mklasinc/lumarca-workshop/README.md

# Lumarca Workshop
This repo contains files related to the Lumarca community building workshop at NYU Abu Dhabi in Fall 2017. <br> [Lumarca](http://lumarca.info/) is a projection mapping project that uses strings distributed in space to project content onto a 3-D display.
