mklasinc/lumarca-workshop/Construction/instructable_printed_instructions.pdf

http://www.instructables.com/id/How-to-Build-a-Wiremap/

All | Art (http://www.instructables.com/art?utm_source=pdf&utm_campaign=categories) | Craft (http://www.instructables.com/craft?utm_source=pdf&utm_campaign=categories) | Food (http://www.instructables.com/food?utm_source=pdf&utm_campaign=categories) | Games (http://www.instructables.com/games?utm_source=pdf&utm_campaign=categories) | Green (http://www.instructables.com/green?utm_source=pdf&utm_campaign=categories) | Home (http://www.instructables.com/home?utm_source=pdf&utm_campaign=categories) | Kids (http://www.instructables.com/kids?utm_source=pdf&utm_campaign=categories) | Life (http://www.instructables.com/life?utm_source=pdf&utm_campaign=categories) | Music (http://www.instructables.com/music?utm_source=pdf&utm_campaign=categories) | Offbeat (http://www.instructables.com/offbeat?utm_source=pdf&utm_campaign=categories) | Outdoors (http://www.instructables.com/outdoors?utm_source=pdf&utm_campaign=categories) | Pets (http://www.instructables.com/pets?utm_source=pdf&utm_campaign=categories) | Photo (http://www.instructables.com/photography?utm_source=pdf&utm_campaign=categories) | Ride (http://www.instructables.com/ride?utm_source=pdf&utm_campaign=categories) | Science (http://www.instructables.com/science?utm_source=pdf&utm_campaign=categories) | Tech (http://www.instructables.com/tech?utm_source=pdf&utm_campaign=categories)

# How to Build a Wiremap

by phedhex (http://www.instructables.com/member/phedhex/?utm_source=pdf&utm_campaign=title) on February 1, 2009

Table of Contents

Author:phedhex author's website (http://www.phedhex.com/) twitter: phedhex

Mailing list:
http://www.phedhex.com/mailing_list/

## Intro: How to Build a Wiremap

The Wiremap is a project that builds digital 3d objects in real 3d space. To create digital 3d objects in real 3d space, a projector is placed in front of a custom designed projection surface made up of an array of vertical wires.

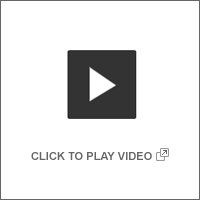
[picture p1: figure]

If you'd like to learn more about the project in general, you can do so at the Wiremap website (http://wiremap.phedhex.com) .

This instructable will show you how to build your own Wiremap from scratch.

Before we begin - let's just make sure that your computer system will run the programs that I've built. For windows users, download the following: http://wiremap.phedhex.com/instructable/wiremap_instructable_windows.zip

For mac & linux, download the following:
http://wiremap.phedhex.com/instructable/wiremap_instructable_nonwin.zip
Then, go to http://www.processing.org and download the program. Processing will allow you to run the programs in the zip.

Windows - open calib_64 -> application.windows -> calib_64.exe. If you see a bunch of multicolored lines going across your whole screen, you're good.

Other OS - open calib_64.pde with processing. If you see a bunch of multicolored lines going across your whole screen, you're good.

Press escape to exit the program.

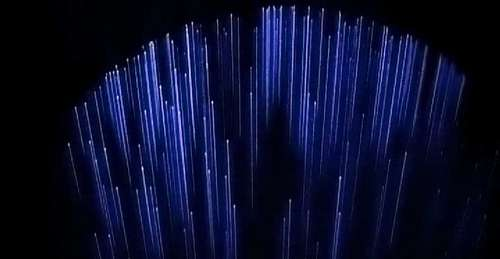
[picture p2: figure]

## Step 1: Understanding the Main Concept

Before we dive in, let's take a look at the anatomy of a Wiremap. The diagram below is a bird's eye view of a projector throwing it's light.

In regular situations, the projector hits a surface at a given distance. Pretend there is a screen at the line labeled "mapline" that the projector is hitting. Now, take that screen and cut it up into a bunch of vertical strips. By moving some strips closer towards the projector, the projector effectively projects in 3d space.

The projector is fed by a computer that has the depths of all the vertical strips memorized. Through this, we can build digital 3d objects in real space.

The Process

Learn about your projector.
Figure out how many wires you want in your wiremap.
Trace out the layout of your projection on some foam core. Mark where you want your wires to go on that foam core. Drop thread through those spots
Calibrate
And run your program

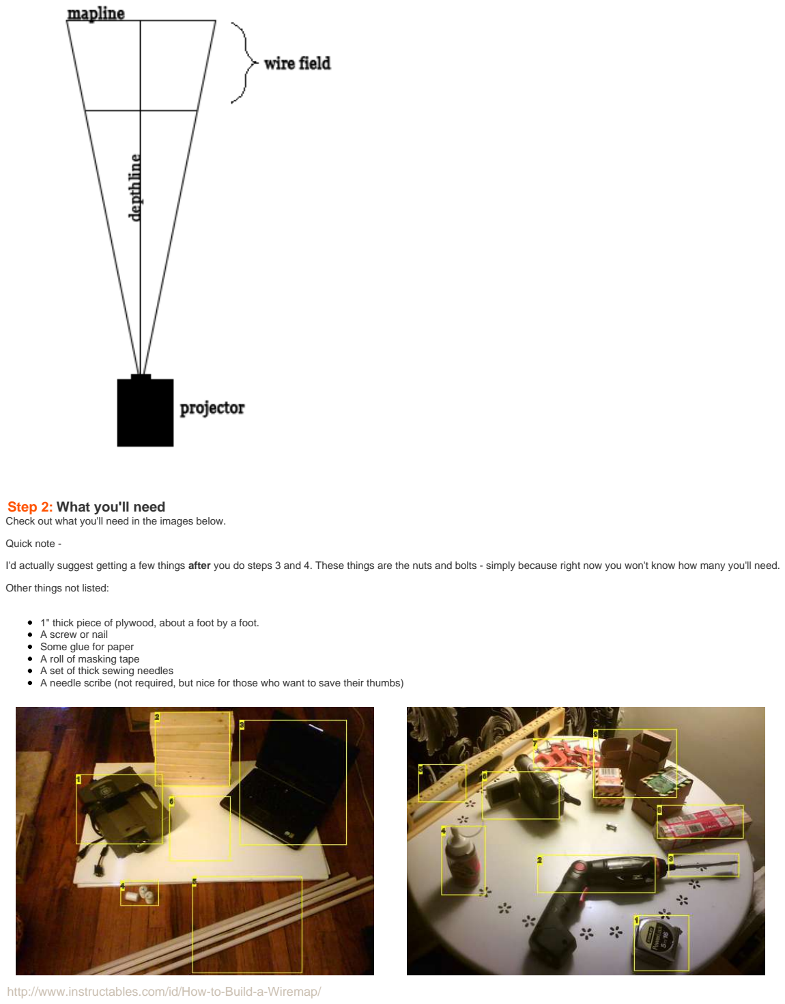
[picture p3: page 3]

## Step 2: What you'll need

Check out what you'll need in the images below.

Quick note -

I'd actually suggest getting a few things after you do steps 3 and 4. These things are the nuts and bolts - simply because right now you won't know how many you'll need.

Other things not listed:

1" thick piece of plywood, about a foot by a foot.
A screw or nail
Some glue for paper
A roll of masking tape
A set of thick sewing needles
A needle scribe (not required, but nice for those who want to save their thumbs)

Image Notes
1. Projector - you probably want a manual zoom (like a twist on the lens) if you have a choice.
2. 2"x4", 8 pieces a foot in length
3. Some sorta computer to feed an image to your projector
4. White thread - you'll want something kinda strong. Get two spools (I used a little over one spool of 125 yards).
5. 4 wood dowels, 3/4 inch in diameter and 4 feet long
6. White Foam core - 3 sheets of 3/8th inch 36"x24".

Image Notes
1. Measuring tape
2. Drill
3. Drill bit - same diameter as your dowels - 3/4 inch
4. Wood glue
5. Level
6. Either a digital camera or camcorder - something with a decent sized screen.
7. 8 C clamps. Wide enough to clamp around your 3/4" dowels
8. Shims
9. Nuts and bolts (check out next image for details)

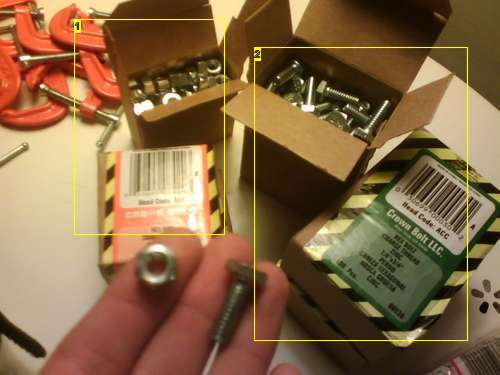
[picture p4: figure]

Image Notes
1. Hex nuts - I got 1/4 inch hex nuts.
2. Bolts that match the threading of the hex nuts. The smaller the length the better

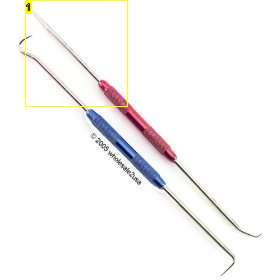
[picture p5: figure]

Image Notes
1. You only need the thin pointy one. Available at craft and hardware stores for about 5 bucks.

## Step 3: Getting to know your projector

In order to design your layout, you'll need to know a few things about your projector. Download and Print out this XL sheet and record your results there: http://wiremap.phedhex.com/instructable/worksheet.xls

Native Aspect Ratio:
Image 1: (width / height)

Throw ratio of the tightest zoom:
Image 1: (width / depth)

Throw ratio of the widest zoom:
Image 2: (width / depth)

Closest focus:
Image 3: Distance from projector to image.

Native resolution:
(not pictured): check your projector's documentation.

As an example, for my particular project, I have these stats:

throw @ tightest zoom: 27" : 72"
throw @ widest zoom: 36" : 72", or 1:2
native aspect: 4:3
Closest focus: 45"
Native res: 1024 x 768

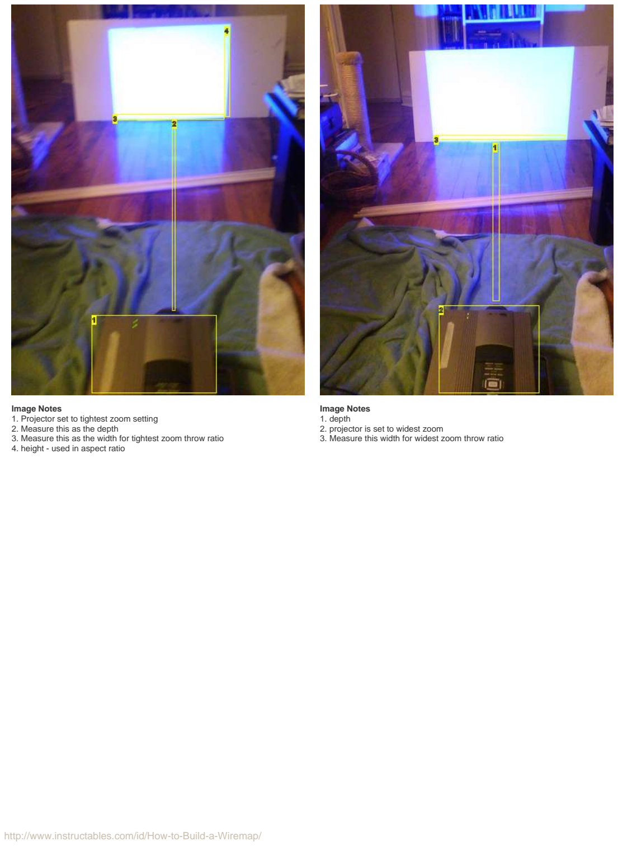
[picture p6: page 5]

Image Notes
1. Projector set to tightest zoom setting
2. Measure this as the depth
3. Measure this as the width for tightest zoom throw ratio
4. height - used in aspect ratio

Image Notes
1. depth
2. projector is set to widest zoom
3. Measure this width for widest zoom throw ratio

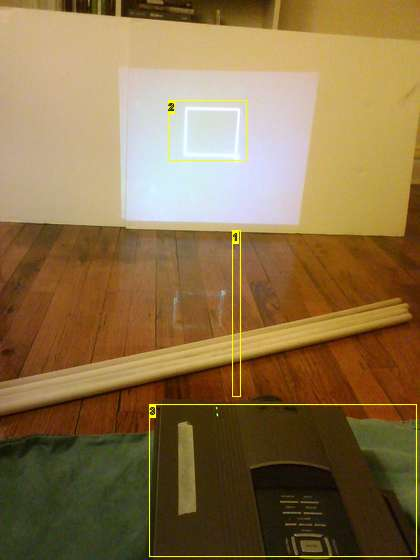
[picture p7: figure]

Image Notes
1. Distance from projector to image for closest focus
2. Make sure the image rendered is as clear as possible
3. Make sure the projector lens is set to the closest focus

## Step 4: How Many Wires?

The number of wires you choose to have in your wiremap will effect you in two ways. With less wires, you'll have an easier time constructing and calibrating your project. With more wires, you'll have to be more precise during construction and calibration, but the end result will have a higher resolution.

If you're looking to learn about the project, 64 wires should be fine. You'll get a good idea as to how things work, and you'll still get a pretty cool effect with a few of the programs. If you're looking for something more challenging, try 96 or so wires. And if you're into intricate work and are willing to spend a bit of time on this project, try 128.

In any case, once you figure out what you want, write down the following on your xl sheet:

64 wires
Available to projectors w/ a horizontal res of 1024, 1152, 1280, or 1920
Mapline Length: 32"
Map Unit: 1/2"
Depth Unit: 1/2"
Depth Levels: 40

80 wires
Available to projectors w/ a horizontal res of 800, 1280, or 1920 Mapline Length: 35"
Map Unit: 7 / 16"
Depth Unit: 7 / 16"
Depth Levels: 45

96 wires
Available to projectors w/ a horizontal res of 1152, or 1920 Mapline Length: 30"
Map Unit: 5 / 16"
Depth Unit: 5 / 16"
Depth Levels: 64

100 wires
Available only if your projector's horizontal res is 800 Mapline Length: 31.25"
Map Unit: 5 / 16"
Depth Unit: 5 / 16"
Depth Levels: 64

128 wires

Available to projectors w/ a horizontal res of 1024, 1152, 1280, or 1920 Mapline Length: 32"
Map Unit: 1/4"
Depth Unit: 1/4"
Depth Levels: 80

How many nuts and bolts do you need? Just take your number of wires and double it!

In case you were wondering what these values are: The mapline length is the width of your projection at a given distance. Remember how I explained this in the beginning with the vertical strips? The number of wires is the number of vertical strips, and the map unit is the distance between each vertical strip.

Determining the Depth

Here are the two guidelines for figuring out how close your wire field is to your projector.

1 - Throw Ratios Notice in the image below: you've got a depthline and a mapline. The length of these lines are the same measurements you used to determine your minimum and maximum throw ratios. The ratio for your plan must fall within your projector's throw ratio.

2 - Closest zoom The center of your wire field must be further than your closest zoom measurement.

So, given that your mapline is a fixed width, find a depth that works for both your throw ratio and your focal distance.

Example please!

So, for my construction, I went with 128. My mapline length is 32".

My widest ratio is 1:2. With a fixed mapline of 32", the depth for this throw ratio would be:

depth = x
1:2 = 32": x corresponding ratios
1 * x = 32" * 2 cross mutiply
x = 64"

My tightest ratio is 27:72.

depth = z
27 : 72 = 32" : z corresponding ratios 27 * z = 32" * 72 cross multiply
z = (72 * 32") / 27 divide
z = 85.333

To fit my projector's throw ratio, my depth must be between 64" and 85"

Closest zoom

My projector's closest zoom distance is 45". The center of the wire field must be greater than 45" away from my projector. Because the wire field is 20" deep (as is everybody's), the center of the wire field is 10" shorter than the depth. So, as long as my map line is greater than 55" out (45" + 10"), then I'll be okay.

For my case, I can just disregard this because my throw ratios are more limiting than that anyhow.

I ended up settling on a 68" depth from my projector to the mapline. This gives me a 4 inch margin of error (I'd always give myself at least a 2" margin of error, just for good measure).

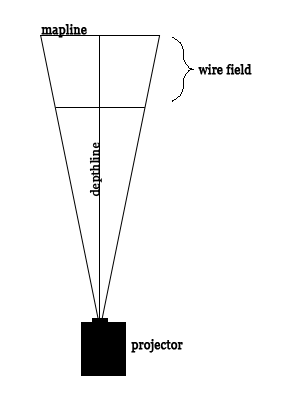
[picture p8: figure]

## Step 5: Determining the Depth

The first step to plotting out your wiremap is to figure out your project's depth. Your Wiremap's depth is the distance from the projector to your mapline. Here are the two guidelines for figuring this out.

1 - Throw Ratios: In the image below there are two angles of projection - the wide zoom and the tight zoom. Because the your mapline length is fixed, the length of the projection is determined by your projector's throw ratios.

2 - Closest Focus: The center of your wire field must be further than your closest focus measurement. Or, in other words, your depthline must be longer than closest focus + 10"

Then, if you have any choice in the matter - a smaller depth tends to make calibration easier.

Example please!

So, for my construction, I went with 128. My mapline length is 32".

My widest ratio is 1:2. With a fixed mapline of 32", the depth for this throw ratio would be:

depth = x
1:2 = 32": x corresponding ratios
1 * x = 32" * 2 cross mutiply
x = 64"

My tightest ratio is 27:72.

depth = z
27 : 72 = 32" : z corresponding ratios 27 * z = 32" * 72 cross multiply
z = (72 * 32") / 27 divide
z = 85.333

To fit my projector's throw ratio, my depth must be between 64" and 85"

Closest zoom

My projector's closest focus distance is 45". The center of the wire field must be greater than 45" away from my projector. Because the wire field is 20" deep (as is everybody's), the center of the wire field is 10" shorter than the depth. So, as long as my map line is greater than 55" out (45" + 10"), then I'll be okay.

For my case, I can just disregard this because my throw ratios are more limiting than that anyhow.

I ended up settling on a 68" depth from my projector to the mapline. This gives me a 4 inch margin of error (I'd always give myself at least a 2" margin of error, just for good measure).

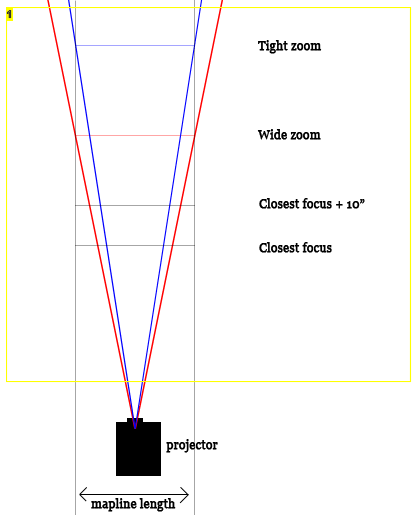
[picture p9: figure]

Image Notes
1. This is an example of where mine land. Yours may land in different places.

## Step 6: Plotting Your Faceplate: Layout

(image 1)
The first step is to draw a line down the center of your foam core. This is your depth line. Next, draw a line along a long edge, 2 inches away from the edge (use another piece of foam core as a straight edge). This is your mapline.

(image 2)
Where the mapline and the depth line is is the center of your mapline. Draw tick marks around the center of your mapline, coming out in either direction. Each tick mark is a "map unit" length away from the next. Half the tick marks on one side of the depth line, half on the other. Note - the depthline is half way between two mapline ticks.

Once you get your tick marks down, the distance between your left-most tick mark and your right-most tick mark should be equal to your mapline length minus one map unit length.

(image 3)
Starting from your left-most tick mark and your right-most tick mark, draw two lines parallel to the depth line. These are your depth level guides.

Along both depth level guide, draw tick marks. Each tick mark is a "depth unit" length away from the next, with the mapline being 0. Draw as many ticks as you have depth levels.

(image 4)
Once you have both depth level guides ticked out, connect them. That is, draw a series of lines parallel to your mapline. Once again, use another piece of foam core as a straight edge.

(image 5)
The last step in plotting your layout is marking everything:

Mark the mapline tick marks from 0 to wires - 1 (for me, I numbered from 0 to 127). 0 is on the left side looking towards the projector.

Mark the depth levels from 0 to however many depth levels you have. The mapline is depth level 0, and the next parallel line is level 1, and so on...

Great! Now you're ready to plot some points.

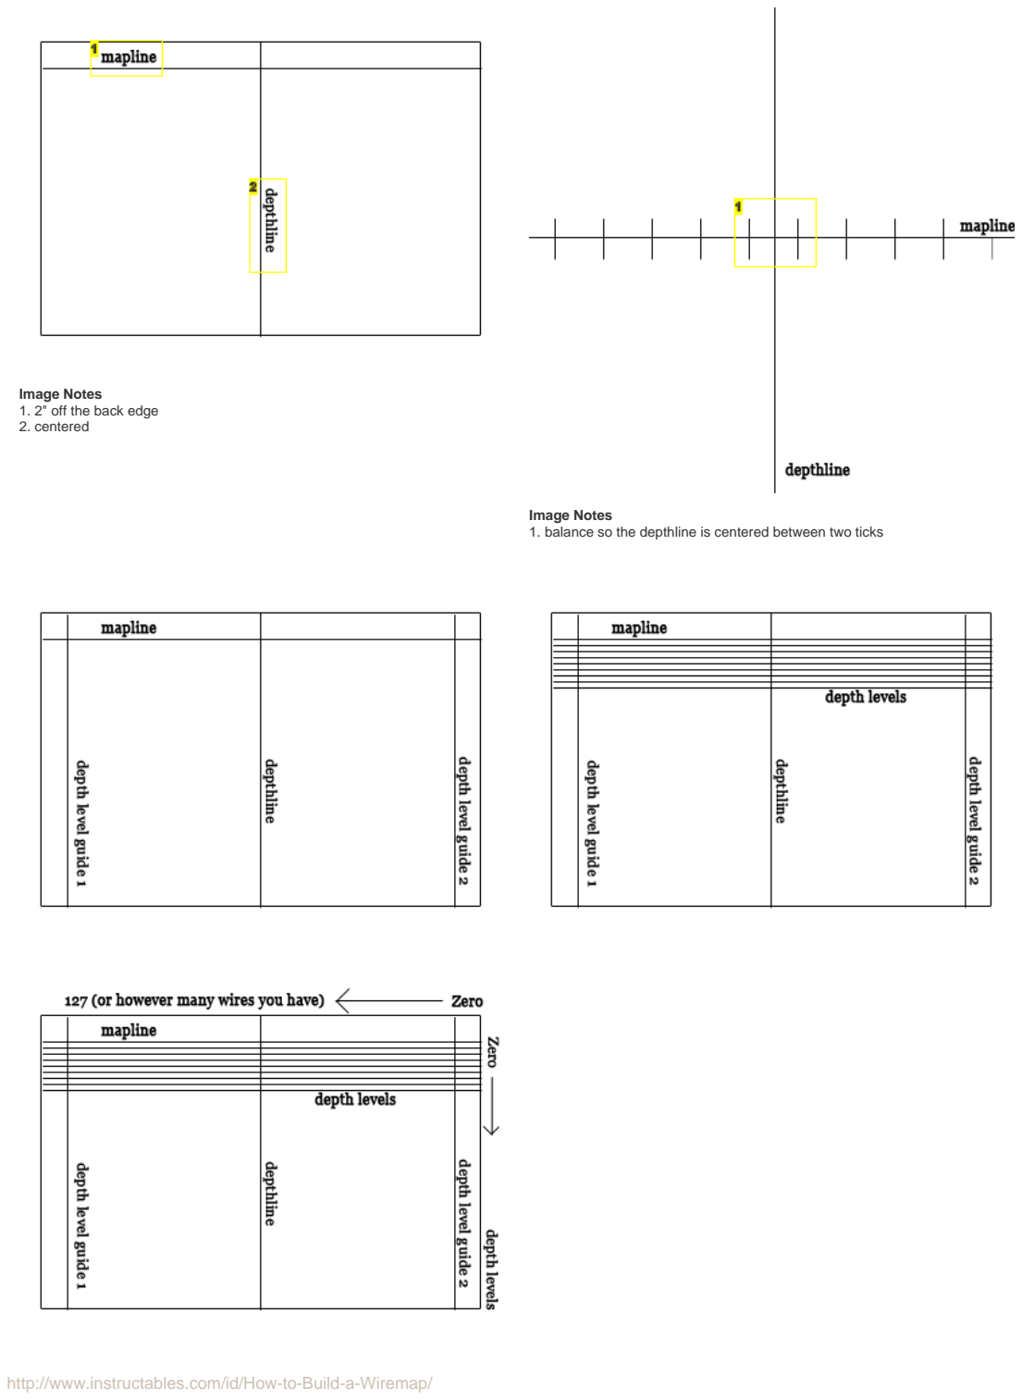
[picture p10: page 10]

Image Notes
1. 2" off the back edge
2. centered

Image Notes
1. balance so the depthline is centered between two ticks

## Step 7: Ray Tracing

In this step, we'll make a straight edge between the projector's focal point and the mapline.

Glue two pieces of foam core together. When gluing them together, try to stay within an inch or two the outside edges (so that when you pierce holes into your foam core, you won't have to struggle through the glue).. Then tape this to the third piece of foam core. Then - tape it all to the floor:

core | ===============
| taped to
core | ===============
| glued to
core | ===============
| taped to
floor _._._._._._._._._._._._._._._._._

Now, measure out where your projector should roughly go (centered on the depth line and as far from the mapline as your depth is). Tape a piece of plywood at that spot.

Draw the depth line onto your plywood. A good way to get the straight edge here is to tape a piece of string to the center of the mapline and pull it taught. When it matches the depthline on the foam core, mark up your plywood and draw it out.

Then, measure from your mapline to draw the intersect - where your projector sits.

Take some thread and tie it off on a hex nut. Drill a screw (or nail a hammer) through the hex nut into the intersection on the plywood.

Now you have a straight edge long enough to follow your path of light!

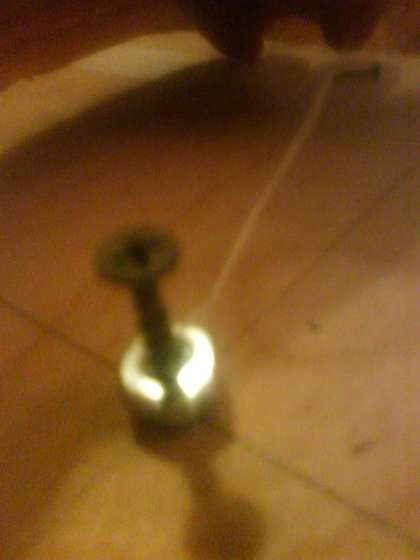
[picture p11: figure]
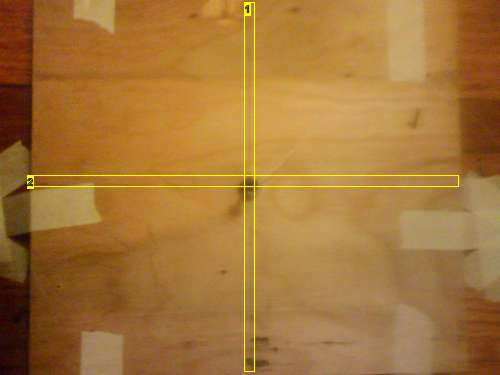
[picture p12: figure]

Image Notes
1. depth line - an extension of the line that goes down the center of the foam core
2. This line is parallel to your mapline, and back as far as your depth.

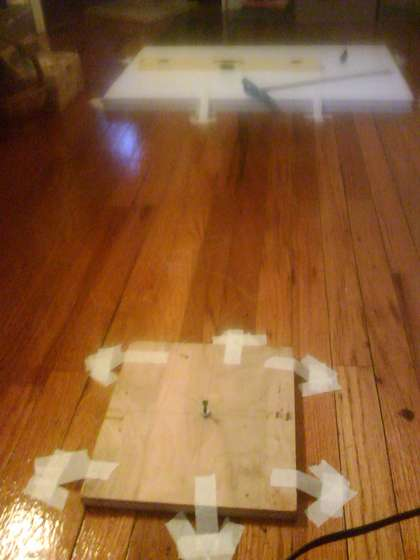
[picture p13: figure]

## Step 8: Mark Your Wires

In the files you downloaded at the beginning of this instructable, go to the "data" directory. Open and print the data file that ends with the wire number you chose.

The files have the following format:

map[0] = 43;
map[1] = 15;

This means that tick 0 on the mapline has a depth of 43, and tick 1 on the mapline has a depth of 15.

Take the string that's tied to the hex nut and pull it tight to tick 0 on the mapline. Then, with a pencil, mark out where the string intersects depth level 43. Move the string to tick mark 1, and mark where the string intersects depth level 15.

You might also want to circle each of these tick marks, just so that they're more visible to you.

Once you're done with this step, you can untape the foam core from the ground (but keep them taped together). Use some clamps to clamp all three together, clamping one on each edge.

Now, use a needle scribe (or just your needles) to puncture holes into your foam core. Drop a hole anywhere there is a tick mark, and try to drop the holes as straight as possible.

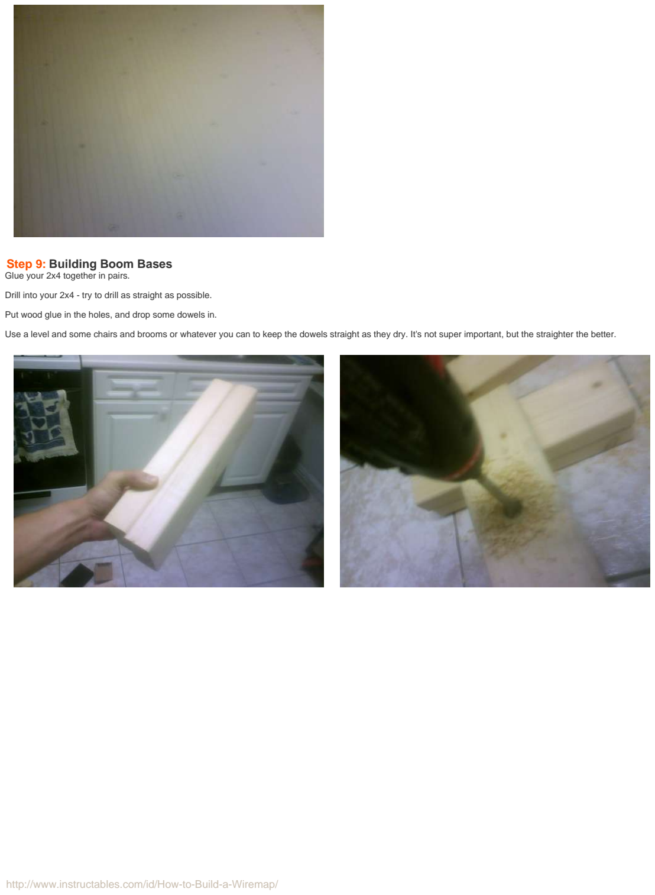
[picture p14: page 13]

## Step 9: Building Boom Bases

Glue your 2x4 together in pairs.

Drill into your 2x4 - try to drill as straight as possible.

Put wood glue in the holes, and drop some dowels in.

Use a level and some chairs and brooms or whatever you can to keep the dowels straight as they dry. It's not super important, but the straighter the better.

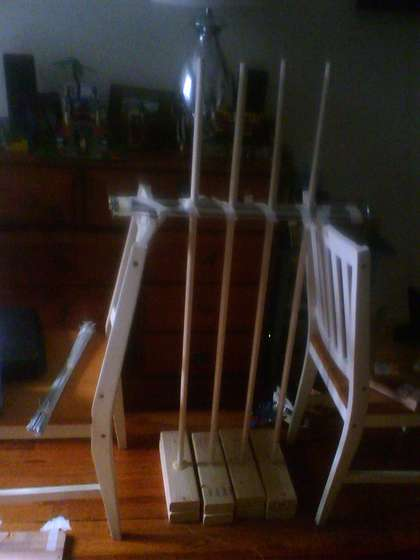
[picture p15: figure]

## Step 10: Prepare your thread

First, we have to find out how long each thread should be. Take the image height at the mapline, and add 8" to it.

The image height of the projection at the mapline is determined by your mapline length and the projector's aspect ratio.

Mapline length / image height = projector aspect ratio.

So, in my case:

32" / image height = 4 / 3
32" * 3 = image height * 4 (cross multiply)
(32" * 3 ) / 4 = image height (divide)
image height = 24"

Once you've found your image height, add 8" to figure out your thread length.

Now, cut as many wires as you need at that length.

tip - find a plank of wood that is half the length of your thread length & wrap your spool around it a bunch of times. This way you can wrap a bunch of times and cut only once!

Then, pull one end of every thread through a hex nut, and bolt it in place.

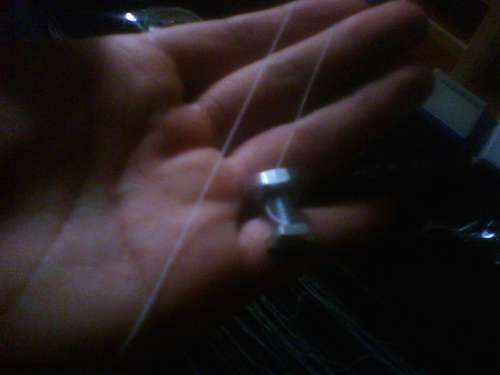
[picture p16: figure]

## Step 11: Setup

(image 1)

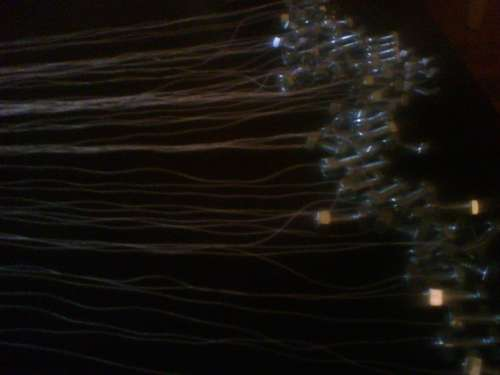
[picture p17: figure]

Take your four boom bases and place them so that they are just outside the footprint of your foam core. Clamp a C clamp at the same height on each boom. You also want most of the c clamp facing inward for the foam core to rest on it.

(image 2)

Rest your foam core on the C clamps. You'll want to orient this the correct way - the mapline on the opposite side of the projector. Also, the faceplate with the tick marks on it should be facing the floor.

(image 3)

Now, use your needle to thread all your threads through all three plates.

When you're finished threading, we need to separate the bottom plate out. Unclamp and untape the plates from one another. Use those four clamps to clamp further down on the dowels to support the bottom plate. This should be about 4 inches above where all your wires end.

Bring all three pieces of foam core down to the bottom C clamps.

Bring the top two pieces of foam core back up to the top.

Rethread any string that came out of the bottom plate.

(image 4)

Tie off the bottom ends of the threads with more nuts and bolts (to weigh it down).

Now, measure everything! Use your level to make sure the plates are level. You'll also want your strings to go straight up and down. One good way to see if your strings go straight up and down is to tie a nut to some extra string and to let it hang next to a thread in your wiremap (image 5). Compare those lines; they should be at the same angle. If they're not, move your plates around until they are.

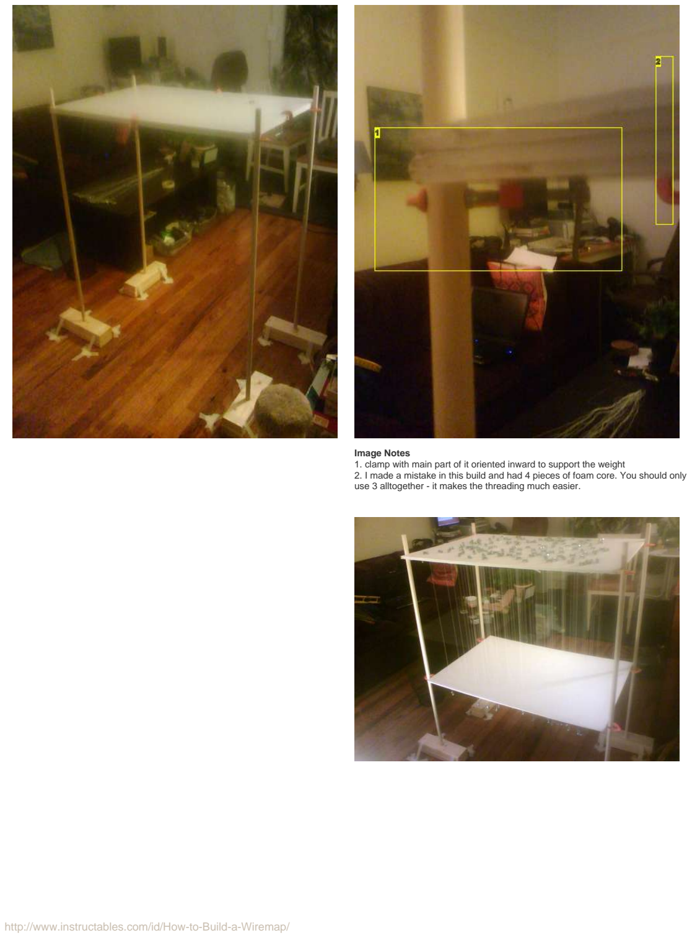
[picture p18: page 16]

Image Notes
1. clamp with main part of it oriented inward to support the weight
2. I made a mistake in this build and had 4 pieces of foam core. You should only use 3 alltogether - it makes the threading much easier.

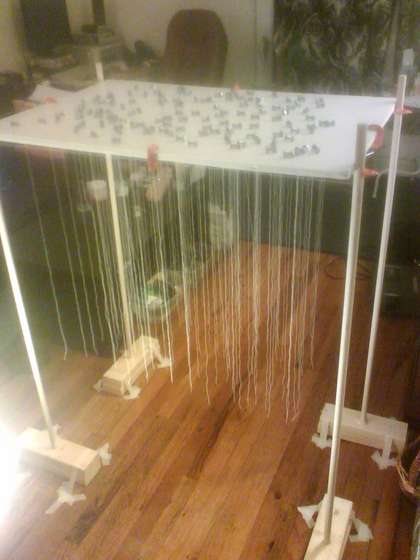
[picture p19: figure]
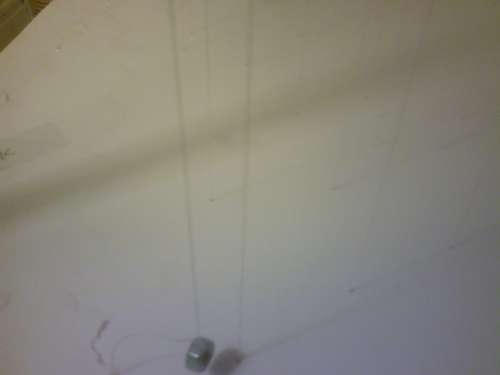
[picture p20: figure]

## Step 12: Calibration

Now all that hard work starts to pay off.

Find out where your projector should go by measuring it out form your construction.

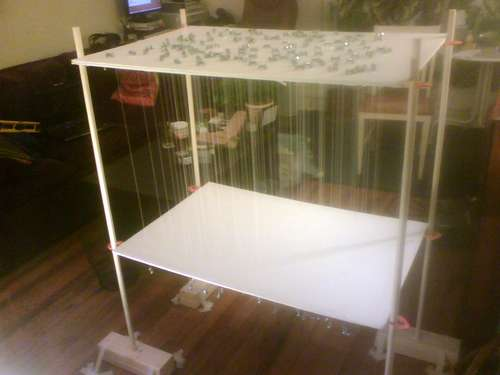
[picture p21: figure]

When you find this spot, take your camcorder or digital camera and put it in that spot (image 1 & 2). If you're precisely where you need to be, you'll see all your wires equidistant from one another. Anywhere else, and they'll overlap. Find that hot spot, and put your projector there.

Fire up your projector and set your computer to match it's native resolution. Get to those files you downloaded and run the calib program with your wire count attached to the end of it.

Once you get that running, you should see a series of vertical strips of light. This program has your wire positions memorized, and it shines a color of light depending on how distant each wire is. The wires that are closest are red, the ones that are furthest are blue, and the ones in between are green.

The first thing you'll want to do is to drop a piece of paper about half way through your strings (maybe even a tad bit closer) to focus your image on it (image 3).

Once you're focused, your wires will probably look something like image 4 below - with each wire having bands of light and darkness. This is because your projector is out of tilt. Fix this by tilting your projector right and left.

Then, you'll probably that one side is out of tilt while the other side is lining up. This is due to the projector being out of tilt in the forward and backward dimension. This is called a keystone distortion, and it can be fixed by tilting your projector up and down. If your image is too fat on the bottom, you need to tilt your projector upwards. If it's too fat on top, tilt it downwards. Use your shims (image 5).

Now, fix the zoom on your projector. You'll want the left side of the image to just be hitting the left-most string, and the right side to be hitting the right-most string.

Try to find that hot spot - & you'll know when you hit it. Keep an eye out for when all the strings closest to you turn red. If you're having trouble, temporarily block the light coming from your projector and pull out your camcorder and try recentering the projector. Play with zoom and projector location. Keep playing with your zoom and location, and you'll find it soon. (image 6)

**tip - the projector's focal point is usually 2 - 3 inches behind the lens.
**tip - also remember that you can make micro adjustments to the foam core - this is very useful especially in the end of the calibration process.

Once you get partially calibrated, it's just lots of small fudging from there. Go up to the wire field and push on a thread in both directions to see which way the light needs to go (images 7 and 8). Take notes, and make a quick diagram:

If the strings need to be pushed this way to resolve:
_ _ _ _ _ _ _ _ _ _
\. .--> | <--. . /
.\ | /
. \ | /
. .\_ _ _ _ _ _ _ _/

... then the light needs to go this way:

_ _ _ _ _ _ _ _ _ _
\. .<-- | -->. . /
.\ | /
. \ | /
. .\_ _ _ _ _ _ _ _/

If the light needs to get wider in the back but is perfect in the front, this means you need to move your projector forward and widen the focus.

Keep making these micro adjustments. This is a very time consuming process, but it's well worth is and pretty much the final step.

And lastly, I've found from experience that I'll get to this point and realize that everything is perfectly aligned except for one or two threads in the middle. This is because their holes are just off center. If you find any of these, just cut those strings, remove them, and move on.

When you're all done, it should look like image 9, below..

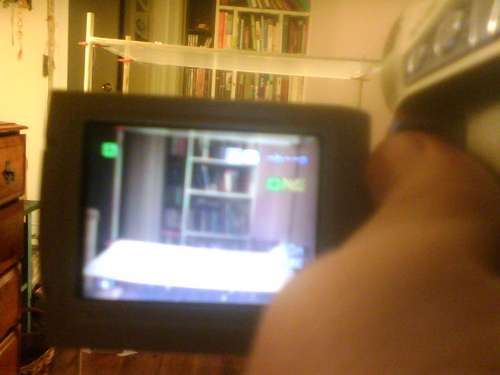
[picture p22: figure]
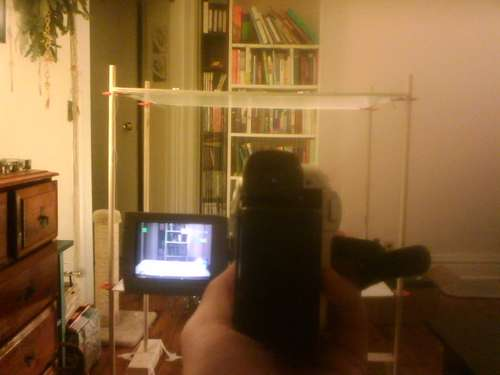
[picture p23: figure]
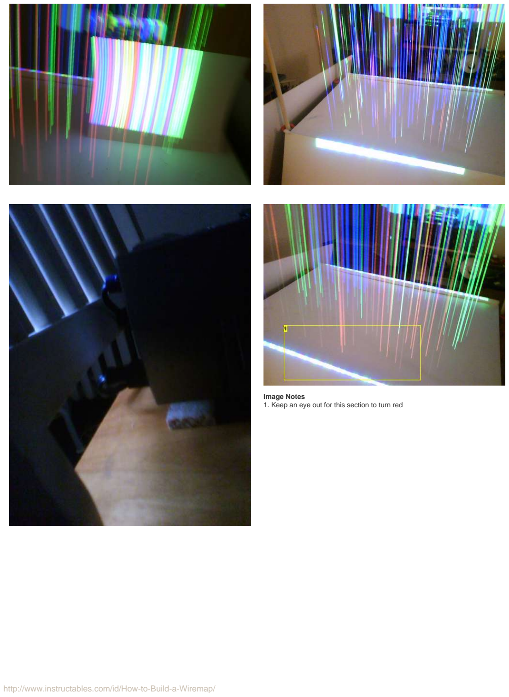
[picture p24: page 19]

Image Notes
1. Keep an eye out for this section to turn red

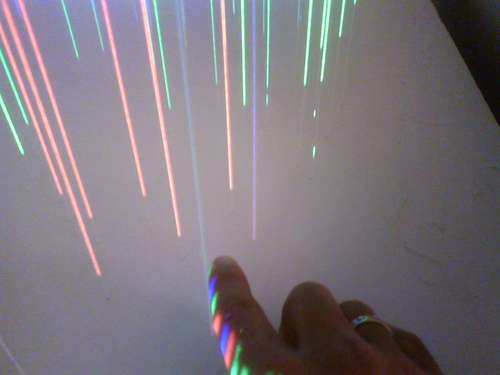
[picture p25: figure]
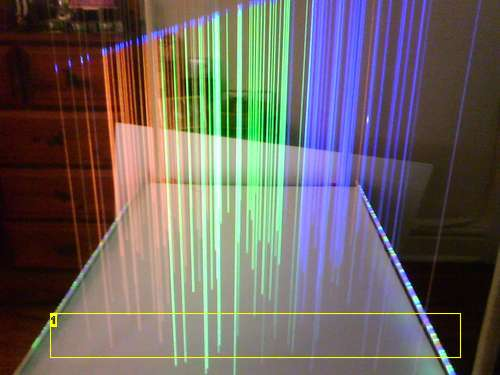
[picture p26: figure]

Image Notes
1. from side view - see? red, green, blue

## Step 13: Run the program

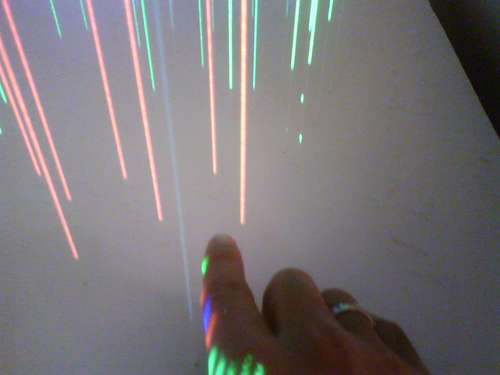
[picture p27: figure]

Now that you're all calibrated - you're set to run your program. Find the sine-surface program that corresponds to your wire count, and run it!

In the program:

Move the mouse to move the ball around.
Click the left mouse to bounce the ball up and down.
Click the right mouse button to toggle the color of the fluid from black to blue.
Press space bar to the beat of some music to have the water oscilate to that rhythm.
Press 'B' if you want to delete the ball altogether.
And press escape to exit.

Also, all the code is open source and the project itself is under the creative commons. Play with the code, and let me know about any developments you make, I'd love to learn about them.

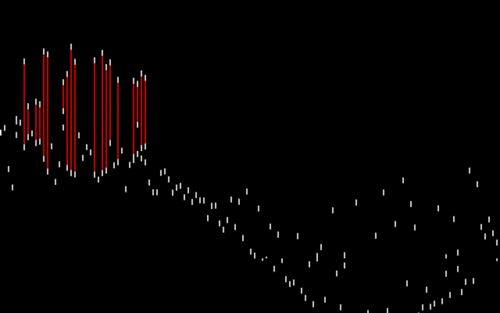
[picture p28: figure]

## Related Instructables

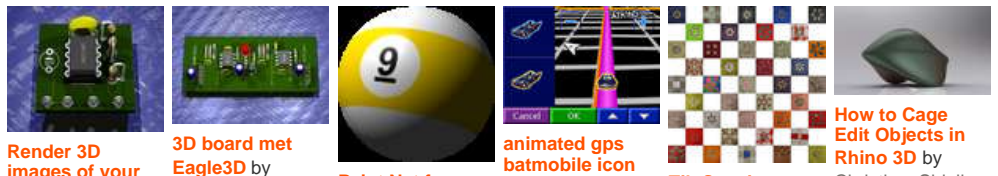
[picture p29: figure]
Render 3D; 3D board met; animated gps; How to Cage Edit Objects in Rhino 3D by

images of your
PCBs using
Eagle3D and
POV-Ray (http://www.instructables.com/id/Render-3D-images-of-your-PCBs-using-Eagle3D-and-PO/) by
ongissim (http://www.instructables.com/member/ongissim/?utm_source=pdf&utm_campaign=related)

Eagle3D (http://www.instructables.com/id/3D-board-met-Eagle3D/?utm_source=pdf&utm_campaign=related) by
berndeijg (http://www.instructables.com/member/berndeijg/?utm_source=pdf&utm_campaign=related) | Paint.Net for
| beginners (http://www.instructables.com/id/PaintNet-for-beginners/?utm_source=pdf&utm_campaign=related) by
| HandyBob (http://www.instructables.com/member/HandyBob/?utm_source=pdf&utm_campaign=related)

batmobile icon
2.0: the 3d way (http://www.instructables.com/id/animated-gps-batmobile-icon-20-the-3d-way/)
by aarrgghh (http://www.instructables.com/member/aarrgghh/?utm_source=pdf&utm_campaign=related)

Tilt Sensing
Quilt (http://www.instructables.com/id/Tilt-Sensing-Quilt/?utm_source=pdf&utm_campaign=related) (Photos) (http://www.instructables.com/id/Tilt-Sensing-Quilt/?utm_source=pdf&utm_campaign=related) by
Plusea (http://www.instructables.com/member/Plusea/?utm_source=pdf&utm_campaign=related)

ChristiaanSidell (http://www.instructables.com/member/ChristiaanSidell/?utm_source=pdf&utm_campaign=related)

## Comments

37 comments | Add Comment (http://www.instructables.com/id/How-to-Build-a-Wiremap/)
joxer15 (http://www.instructables.com/member/joxer15/?utm_source=pdf&utm_campaign=comments) says: | Feb 18, 2009. 9:10 AM REPLY (http://www.instructables.com/id/How-to-Build-a-Wiremap/?utm_source=pdf&utm_campaign=comments#DISCUSS)
ill go build this. ill maybe use 640 wires (=
positioning of wires is randomly?
phedhex (http://www.instructables.com/member/phedhex/?utm_source=pdf&utm_campaign=comments) says: | Feb 18, 2009. 10:20 AM REPLY (http://www.instructables.com/id/How-to-Build-a-Wiremap/?utm_source=pdf&utm_campaign=comments#DISCUSS)
Hi there Joxer - Projector's are designed to focus on a plane, not a field, so when you shoot a projection into a field of wires, many of the wires are out of focus. It took me 3 solid days to do my first calibration with 256, so I'd suggest starting small and working your way up. The wire positions are pretty close to random - I weighted the 'randomization' to the wider side of the trapezoid to get a more even distribution. After that I manually changed a few that were right next to each other. I was going to upload this code also, but some of it is in Ruby and I didn't want to confuse people. If you're interested in it,
gimme a holler and I'll find a way to get it to you.
imarichardson (http://www.instructables.com/member/imarichardson/?utm_source=pdf&utm_campaign=comments) says: | Jan 2, 2011. 12:42 PM REPLY (http://www.instructables.com/id/How-to-Build-a-Wiremap/?utm_source=pdf&utm_campaign=comments#DISCUSS)
Phedhex. I'm a little late to the game but really interested in this project. You mentioned that you have the Ruby code for the randomization. If you don't mind can I have access for this? Perhaps posting on github would be an option too. If you do my username is imarichardson.
idmism (http://www.instructables.com/member/idmism/?utm_source=pdf&utm_campaign=comments) says: | Aug 21, 2009. 9:53 AM REPLY (http://www.instructables.com/id/How-to-Build-a-Wiremap/?utm_source=pdf&utm_campaign=comments#DISCUSS)
how do you sequence the sine surface and runs as one continuously loop in processing??
phedhex (http://www.instructables.com/member/phedhex/?utm_source=pdf&utm_campaign=comments) says: | Aug 24, 2009. 8:10 PM REPLY (http://www.instructables.com/id/How-to-Build-a-Wiremap/?utm_source=pdf&utm_campaign=comments#DISCUSS)
Hi idmism - I'm don't know if I understand your question. Could you please be more specific?
joxer15 (http://www.instructables.com/member/joxer15/?utm_source=pdf&utm_campaign=comments) says: | Feb 19, 2009. 12:17 AM REPLY (http://www.instructables.com/id/How-to-Build-a-Wiremap/?utm_source=pdf&utm_campaign=comments#DISCUSS)
i am very interested in this. So i have other idea of ... In mine 3d projection each wire has exactly one position and each colum of pixels from projector will lighting on one wire in 3d table. Could you writte your email please? I would to write you. Thanks
jerickson (http://www.instructables.com/member/jerickson/?utm_source=pdf&utm_campaign=comments) says: | Nov 4, 2010. 7:53 AM REPLY (http://www.instructables.com/id/How-to-Build-a-Wiremap/?utm_source=pdf&utm_campaign=comments#DISCUSS)
im thinking about doing this for a school project but for us to get credit it would have to look like yours in the video. im not getting how you lay out the strings or is it random to a point?

phedhex (http://www.instructables.com/member/phedhex/?utm_source=pdf&utm_campaign=comments) says: | Nov 4, 2010. 9:37 AM REPLY (http://www.instructables.com/id/How-to-Build-a-Wiremap/?utm_source=pdf&utm_campaign=comments#DISCUSS)
I use a computer algorithm to place the strings that is designed to keep the strings as far away from one another as possible.
MillenniumMan (http://www.instructables.com/member/MillenniumMan/?utm_source=pdf&utm_campaign=comments) says: | Mar 8, 2010. 12:52 PM REPLY (http://www.instructables.com/id/How-to-Build-a-Wiremap/?utm_source=pdf&utm_campaign=comments#DISCUSS)
They had something like this but much more advanced on the X-men movie, and they used ferrofluids instead of wires.

Remember the simulation table when the Professor showed what would happen to New York if that magneto wave hit the city?

That is similar to this, but yours has pretty colors, not all greyish.

cdousley (http://www.instructables.com/member/cdousley/?utm_source=pdf&utm_campaign=comments) says: | Sep 4, 2010. 11:01 AM REPLY (http://www.instructables.com/id/How-to-Build-a-Wiremap/?utm_source=pdf&utm_campaign=comments#DISCUSS)
i think i saw one on avatar that they were using as a map. ive seen these on all kinds of movies but i never knew they were real
oppemi (http://www.instructables.com/member/oppemi/?utm_source=pdf&utm_campaign=comments) says: | May 17, 2010. 4:12 AM REPLY (http://www.instructables.com/id/How-to-Build-a-Wiremap/?utm_source=pdf&utm_campaign=comments#DISCUSS)
It's awesome. I'd like to build one my self. But, can you place the wires randomly around in the wire field? And what types of wires do you use, normal threads?
Friggin Smift (http://www.instructables.com/member/Friggin+Smift/?utm_source=pdf&utm_campaign=comments) says: | Aug 29, 2010. 4:03 PM REPLY (http://www.instructables.com/id/How-to-Build-a-Wiremap/?utm_source=pdf&utm_campaign=comments#DISCUSS)
In the download file you'll find a file that has a sort of (x,y) coordinate system for marking and drilling the holes for the wires. I suppose it would be best to use a nice white thread for this.
kal00 (http://www.instructables.com/member/kal00/?utm_source=pdf&utm_campaign=comments) says: | Jan 3, 2010. 4:14 AM REPLY (http://www.instructables.com/id/How-to-Build-a-Wiremap/?utm_source=pdf&utm_campaign=comments#DISCUSS)
This is one of the most incredible things I've ever seen, congratulations and thanks for posting! So... were you able to render cityscapes or other 3d objects like rotating cubes and such? The first thing that popped into my mind was rendering of 3d objects using SolidWorks and AutoCAD, it would be awesome to display it. Thanks!
phedhex (http://www.instructables.com/member/phedhex/?utm_source=pdf&utm_campaign=comments) says: | Jan 3, 2010. 6:44 AM REPLY (http://www.instructables.com/id/How-to-Build-a-Wiremap/?utm_source=pdf&utm_campaign=comments#DISCUSS)
Thanks Kal!

Actually, one of my colleagues rendered out a car - take a look:

http://www.vimeo.com/1400012

kal00 (http://www.instructables.com/member/kal00/?utm_source=pdf&utm_campaign=comments) says: | Jan 3, 2010. 4:13 PM REPLY (http://www.instructables.com/id/How-to-Build-a-Wiremap/?utm_source=pdf&utm_campaign=comments#DISCUSS)
How was he able to do that? Lets just say I have the system ready, How would you "export" images or 3d objects into your software? Thankss!!
phedhex (http://www.instructables.com/member/phedhex/?utm_source=pdf&utm_campaign=comments) says: | Jan 23, 2010. 7:36 PM REPLY (http://www.instructables.com/id/How-to-Build-a-Wiremap/?utm_source=pdf&utm_campaign=comments#DISCUSS)
Hey there -

Sorry it took so long for me to reply.

Yeah, I'm actually more a lighting and hardware geek than that. I actually don't really know how he accomplished it. I'd say get in touch with him. He likes this project, so he's pretty responsive about that sorta stuff. You can hit him up over at that Vimeo page or just message his Vimeo acct, i'm sure he'd respond.

kal00 (http://www.instructables.com/member/kal00/?utm_source=pdf&utm_campaign=comments) says: | Jan 23, 2010. 8:38 PM REPLY (http://www.instructables.com/id/How-to-Build-a-Wiremap/?utm_source=pdf&utm_campaign=comments#DISCUSS)
No worries my friend... Ok, I'll get in touch with him and ask him how to export 3d objects, thanks! all the best.
ekuhlkamp (http://www.instructables.com/member/ekuhlkamp/?utm_source=pdf&utm_campaign=comments) says: | Apr 27, 2009. 6:17 PM REPLY (http://www.instructables.com/id/How-to-Build-a-Wiremap/?utm_source=pdf&utm_campaign=comments#DISCUSS)
Awesome.
mever (http://www.instructables.com/member/mever/?utm_source=pdf&utm_campaign=comments) says: | Feb 25, 2009. 5:05 PM REPLY (http://www.instructables.com/id/How-to-Build-a-Wiremap/?utm_source=pdf&utm_campaign=comments#DISCUSS)
WOW!, This is top notch! Great work on the Instructable and an awesome project. I haven't had time to work on much in a while but this is something I want to play with. Thank you for taking the time to post this.
userhck (http://www.instructables.com/member/userhck/?utm_source=pdf&utm_campaign=comments) says: | Feb 21, 2009. 11:55 AM REPLY (http://www.instructables.com/id/How-to-Build-a-Wiremap/?utm_source=pdf&utm_campaign=comments#DISCUSS)
Could this be synced to music somehow?

pinhole (http://www.instructables.com/member/pinhole/?utm_source=pdf&utm_campaign=comments) says: | Feb 14, 2009. 12:53 AM REPLY (http://www.instructables.com/id/How-to-Build-a-Wiremap/?utm_source=pdf&utm_campaign=comments#DISCUSS)
Actually it's needless to say, but this is very cool! I wish you many more happy wiremappings !
FuzzyBearGeek (http://www.instructables.com/member/FuzzyBearGeek/?utm_source=pdf&utm_campaign=comments) says: | Feb 13, 2009. 6:33 AM REPLY (http://www.instructables.com/id/How-to-Build-a-Wiremap/?utm_source=pdf&utm_campaign=comments#DISCUSS)
You are strange. Thank god! We need more people with creative minds. Obvious, I know. Thanks for the hard work and well put together instructable.
frikkie (http://www.instructables.com/member/frikkie/?utm_source=pdf&utm_campaign=comments) says: | Feb 13, 2009. 12:39 AM REPLY (http://www.instructables.com/id/How-to-Build-a-Wiremap/?utm_source=pdf&utm_campaign=comments#DISCUSS)
Oh dear I thought of something else when I read the titel of the instructable. Well it looks nice.
dchall8 (http://www.instructables.com/member/dchall8/?utm_source=pdf&utm_campaign=comments) says: | Feb 9, 2009. 8:15 AM REPLY (http://www.instructables.com/id/How-to-Build-a-Wiremap/?utm_source=pdf&utm_campaign=comments#DISCUSS)
This takes me back to the 1970s when you could go to a company called Heath Kit and buy a computer that you had to assemble yourself. When you got it assembled and running you could turn on the LEDs built into the computer. That's all, turn on the lights. And they sold them by the thousands!!
teddlesruss (http://www.instructables.com/member/teddlesruss/?utm_source=pdf&utm_campaign=comments) says: | Feb 13, 2009. 12:28 AM REPLY (http://www.instructables.com/id/How-to-Build-a-Wiremap/?utm_source=pdf&utm_campaign=comments#DISCUSS)
There was a kit made for an electronics magazine based on an "SC-MP" chip that did 4 bit calculation with toggle switches and front panel LEDs, I think it was called the "Mini SCaMP" or something, I built one up and that was the first computer I ever owned... How times have changed...
teddlesruss (http://www.instructables.com/member/teddlesruss/?utm_source=pdf&utm_campaign=comments) says: | Feb 13, 2009. 12:33 AM REPLY (http://www.instructables.com/id/How-to-Build-a-Wiremap/?utm_source=pdf&utm_campaign=comments#DISCUSS)
http://oldcomputermuseum.com/mini_scamp.html
midiwall (http://www.instructables.com/member/midiwall/?utm_source=pdf&utm_campaign=comments) says: | Feb 12, 2009. 10:32 PM REPLY (http://www.instructables.com/id/How-to-Build-a-Wiremap/?utm_source=pdf&utm_campaign=comments#DISCUSS)
Hmmm... Are you thinking about the EC-1? That was an analog computer, and could be programmed to solve problems, though nothing very practical by today's standards. :)

ref: http://www.heathkit-museum.com/computers/hvmec-1.shtml

A good name (http://www.instructables.com/member/A+good+name/?utm_source=pdf&utm_campaign=comments) says: | Feb 12, 2009. 3:36 PM REPLY (http://www.instructables.com/id/How-to-Build-a-Wiremap/?utm_source=pdf&utm_campaign=comments#DISCUSS)
What are some applications of this? I'm not sure I really understand what it is.
cryophile (http://www.instructables.com/member/cryophile/?utm_source=pdf&utm_campaign=comments) says: | Feb 11, 2009. 1:02 PM REPLY (http://www.instructables.com/id/How-to-Build-a-Wiremap/?utm_source=pdf&utm_campaign=comments#DISCUSS)
Earlier I asked a question before regarding whether or not it would be possible to render complex models such as cities using this method, but it seems the board ate my comment. Also, have you tried using monofilament for your wires, or would that not work? Does the surface your are projecting onto have to be reflective, or could it have fiberoptic properities?
phedhex (http://www.instructables.com/member/phedhex/?utm_source=pdf&utm_campaign=comments) says: | Feb 11, 2009. 2:04 PM REPLY (http://www.instructables.com/id/How-to-Build-a-Wiremap/?utm_source=pdf&utm_campaign=comments#DISCUSS)
Hey Cryo - theoretically, it would be possible to render cityscapes or topographies, but I just haven't been able do any of that sort of work because of how difficult that is. I should take another look at that, though. A friend has used monofilament, and it seems to work - although it's not quite as bright. My suggestion is to get opaque materials.
PKM (http://www.instructables.com/member/PKM/?utm_source=pdf&utm_campaign=comments) says: | Feb 9, 2009. 4:37 AM REPLY (http://www.instructables.com/id/How-to-Build-a-Wiremap/?utm_source=pdf&utm_campaign=comments#DISCUSS)
I like it- it's a nice low(ish) tech solution to 3D volumetric display. Not sure I'd build one, it sounds like it takes a lot of effort, but I love the concept. Of course, the next thing I'm going to ask is do you have a library to render arbitrary 3D objects on the display? Also, if you had either unlimited patience or some kind of robot to do it for you, couldn't you build a 1024-wire version for much higher res?
phedhex (http://www.instructables.com/member/phedhex/?utm_source=pdf&utm_campaign=comments) says: | Feb 9, 2009. 9:14 AM REPLY (http://www.instructables.com/id/How-to-Build-a-Wiremap/?utm_source=pdf&utm_campaign=comments#DISCUSS)
I have a contact with an engineer in Manchester who has built plugins for other types of rendering capabilities. We have an arrangement where my code is open source and his is closed so as to protect his work. At any rate, yes, we can build higher res projects - I have a 256 in my apt, and Elliot (guy from Manchester) has built larger ones. One of the interesting limiting factors is that the focus on the projector isn't designed to dither in 3d, so you get these weird blurring issues. My hope is to wait out for laser projectors and go really high res.
PKM (http://www.instructables.com/member/PKM/?utm_source=pdf&utm_campaign=comments) says: | Feb 9, 2009. 10:56 AM REPLY (http://www.instructables.com/id/How-to-Build-a-Wiremap/?utm_source=pdf&utm_campaign=comments#DISCUSS)
Speaking of laser projectors, I was going to link you to an idea using a scanning laser to illuminate specific falling water droplets in a volume, but a) I can't find it anywhere online, just people popping balloons with their laser pointers, and b) judging by a youtube video I stumbled on (something involving laser cut plexi and water) you may already be familiar with the concept. If you know of any videos of a working model of what I just described please post a link, my boss doesn't believe they exist. I'm working towards my own projects involving 3D stuff actually, I can't wait until some of this tech becomes more ubiquitous and I have more toys to play with :)
ste5442 (http://www.instructables.com/member/ste5442/?utm_source=pdf&utm_campaign=comments) says: | Feb 9, 2009. 4:00 AM REPLY (http://www.instructables.com/id/How-to-Build-a-Wiremap/?utm_source=pdf&utm_campaign=comments#DISCUSS)
Excellent instructable!
Not something I have the time (or money!) to achieve but very impressive. You may have something you can take to market!
I am sure that various marketing or event organisers woudl love to have a demo - maybe on a larger scale though?!

PCBPolice (http://www.pcbpolice.com/)

phedhex (http://www.instructables.com/member/phedhex/?utm_source=pdf&utm_campaign=comments) says: | Feb 9, 2009. 9:11 AM REPLY (http://www.instructables.com/id/How-to-Build-a-Wiremap/?utm_source=pdf&utm_campaign=comments#DISCUSS)
Thanks for your comment! Yeah, actually, I have a larger one (256) that I take to events regularly. And if anybody is interested in events, contact me!
thatsgreat2345 (http://www.instructables.com/member/thatsgreat2345/?utm_source=pdf&utm_campaign=comments) says: | Feb 8, 2009. 11:10 PM REPLY (http://www.instructables.com/id/How-to-Build-a-Wiremap/?utm_source=pdf&utm_campaign=comments#DISCUSS)
This is awesome , when I get a house in college this would be cool to rig up like under the floor, possibly code up something to analyze the music and control the program , would make for an awesome party.
dan moulton (http://www.instructables.com/member/dan+moulton/?utm_source=pdf&utm_campaign=comments) says: | Feb 8, 2009. 11:06 PM REPLY (http://www.instructables.com/id/How-to-Build-a-Wiremap/?utm_source=pdf&utm_campaign=comments#DISCUSS)
Wow this is really fantastic. And a really detailed instructable, thanks for sharing.
