mklasinc/lumarca-workshop/Construction/lumarca_worksheet.xls

 | Your Project | format | Instructable | EPSON EB-1XB
Projector Stats
Native Aspect Ratio |  | Width : Height | 4:3 | 4:3
Throw Ratio - widest zoom |  | Width : Distance | 1:2 | width x 1.48
Throw Ratio - tightest zoom |  | Width : Distance | 27:72 | width x 1.77
Closest focus |  | Distance | 45" | 45"
Native Resolution |  | Width : Height | 1024 x 768 | 1024 x 768
Layout Stats
Number of wires |  | # | 128 | 64
Mapline length |  | Length in " | 32" | 32"
Map unit |  | Length in " | 1/4" | 1/2"
Depth Unit |  | Length in " | 1/4" | 1/2"
Depth Levels |  | # | 80 | 40
Determining Depth
Tight Zoom |  | Length in " | 85.333" | 56.64"
Wide Zoom |  | Length in " | 64" | 47.36"
Closest focus |  | Length in " | 45" | 45"
Closest focus plus 10" |  | Length in " | 55" | 55"
You Project's Depth |  | Length in " | 68" | 52''
Thread Length
Image Height |  | Length in " | 24" | 24"
Thread Height |  | Length in " | 32" | 32"
