mklasinc/lumarca-workshop/Construction/diagrams/03_layout_plot1.gif

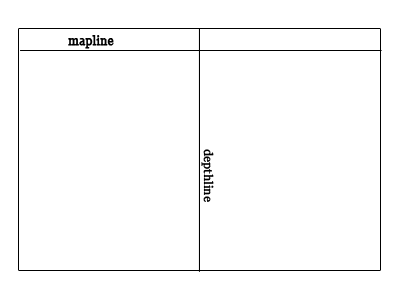
Construction/diagrams/03_layout_plot1.gif
