mklasinc/lumarca-workshop/Construction/diagrams/04_layout_plot2.gif

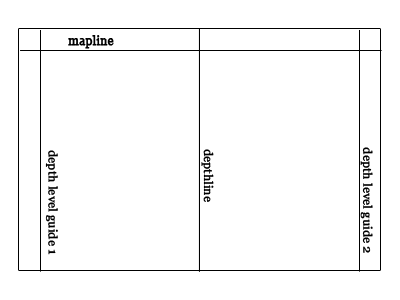
Construction/diagrams/04_layout_plot2.gif
