mklasinc/lumarca-workshop/Construction/diagrams/05_layout_plot3.gif

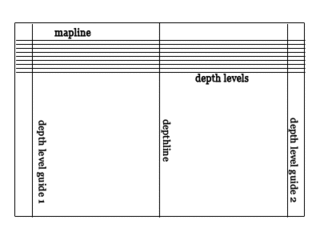
Construction/diagrams/05_layout_plot3.gif
