mklasinc/lumarca-workshop/Construction/diagrams/06_layout_plot4.gif

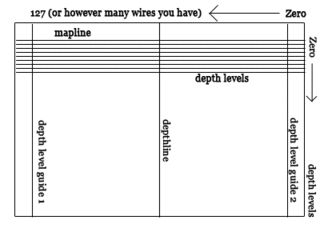
Construction/diagrams/06_layout_plot4.gif
