mklasinc/lumarca-workshop/Construction/diagrams/07_layout_plot5.gif

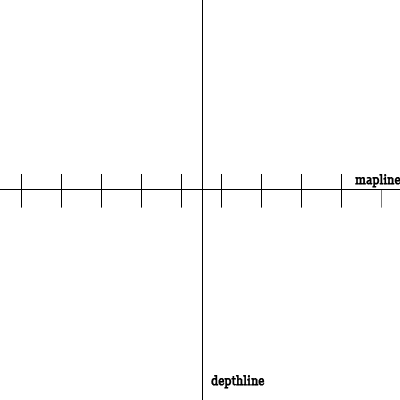
Construction/diagrams/07_layout_plot5.gif
