mklasinc/lumarca-workshop/Code/workshop_nyuad/test/processing/gradients/gradients.pde

// Constants
int Y_AXIS = 1;
int X_AXIS = 2;
color b1, b2, c1, c2;

void setup() {
  size(640, 360);

  // Define colors
  b1 = color(255);
  b2 = color(0);
  c1 = color(204, 102, 0);
  c2 = color(0, 102, 153);

  noLoop();
}

void draw() {
  // Foreground
  setGradient(50, 90, 540, 80, c1, c2, Y_AXIS);
  //setGradient(50, 190, 540, 80, c2, c1, X_AXIS);
}

void setGradient(int x, int y, float w, float h, color c1, color c2, int axis ) {

  noFill();
// Top to bottom gradient
    for (int i = y; i <= y+h; i++) {
      float inter = map(i, y, y+h, 0, 1);
      color c = lerpColor(c1, c2, inter);
      stroke(c);
      line(x, i, x+w, i);
    }
}
