mklasinc/lumarca-workshop/(commit log)

2017-11-02 "first commit"
    [lumarca_worksheet.xls]
2017-11-02 changed folder structure
    [lumarca_worksheet.xls]
2017-11-03 added printed instructions
2017-11-03 "updated worksheet info"
    [lumarca_worksheet.xls]
